fu-07/robot2/docs/overview.md

# 陆地仿生机器人挑战赛 —— 工程总纲（8 自由度四足机器人）

> 本文从原对话（`机器人挑战赛通知摘要`，800 条消息 / 151 万字符）中提炼，**只保留最终采用的方案、可直接复用的参数和真实踩过的坑**，已剔除所有被否决的中间方案。
> 用途：作为新对话的工程上下文 / 写设计说明书 / 答辩复盘。
> 最后更新：2026-10-31

---

## 0. 一句话概括

用 **STM32F103C8T6 + 8 个 SG90 舵机**做一只 8 自由度四足（机器狗）机器人，**纯开环 8 相位步态**走完 900 mm 直道，靠 **HC-05 蓝牙单步微调**做终点精准停靠，电源用 **2S 锂电 + XL4015 降压 + 2×1000 µF**，控制板为自制 **50×80 mm 双层 PCB**（Gerber 已出），机身是 **3D 打印件（75×66×10 mm）**。

**当前状态**：站立稳定；直行能走直线（最好记录 57 cm）；已加入原地左/右转；`TARGET_STEPS` 仍未标定；OLED 用 **PB12/PB13** 已点亮并能显示表情；代码工程见 `D:\下载\robot2-main`（Keil MDK，已含全部 HAL 驱动）。

---

## 1. 赛题与得分策略

### 1.1 硬性规则（来自《机器人挑战赛通知.docx》）

| 项目 | 要求 |
| --- | --- |
| 赛事 | 陆地仿生机器人挑战赛 / 2026 集成电路创新实验室招新校赛 |
| 队伍 | 2 人，机械 + 电控各 1 人 |
| 尺寸 | 静置长宽高 **均 ≤ 150 mm** |
| 驱动 | 至少 1 个电机；主推进必须靠**仿生运动机构**（轮/履带只能辅助） |
| 供电 | 仅限锂电池，**≤ 12 V** |
| 主控 | STM32 / ESP32 / Arduino |
| 关键约束 | **禁止电机开环输出**（这条决定了必须做位置闭环或"舵机内置闭环"） |
| 代码 | 必须有清晰注释，现场演示 + 答辩 |
| 赛道 | 宽 **200 mm**、长 **900 mm** |
| 基础任务 | 直行通过 900 mm，不得冲出赛道 |
| 附加任务 | 精准停靠到起跑点正对面，且机身整体越过终点线 |
| 计时 | 单次 **90 s**，赛前准备 90 s，每队 **2 次**机会取最高分 |
| 计分 | 按 900 mm 方向的有效行走距离计任务分；总分 = 现场评定 + 文档 + 创新 + 任务（100 分） |

### 1.2 本队的得分打法（已确定，不再改）

1. **基础分优先**：宁可慢，必须走完 900 mm 且不出界（出界立即停止，按出界点计分）。
2. **附加分靠"人机协同"**：不做视觉/循迹，用手机蓝牙发单步指令，肉眼对准终点线一点点挪——这是低成本方案里最稳的精准停靠。
3. **创新分靠硬件**：自制 PCB + 模块化舵机接口 + 双模控制（蓝牙 + 物理按键应急）。
4. **答辩分靠设计叙事**：8 相位错峰、非阻塞调度、电源抗扰——三个点足够讲。

### 1.3 时间预算（90 s）

| 环节 | 预算 |
| --- | --- |
| 上电自检 + 站立 | 2 s |
| 直行 900 mm | 18~30 s（0.4 s/步 × 45~75 步） |
| 蓝牙微调停靠 | 30~40 s（每按一次走 1 步） |
| 余量 | ≥ 20 s |

---

## 2. 系统总览

### 2.1 系统框图

```
        ┌──────────────┐   USART1 9600   ┌──────────┐
        │  手机 APP     │◄───────────────►│  HC-05   │
        └──────────────┘                 └────┬─────┘
                                              │ PA9/PA10
   ┌─────────────┐   8×PWM(50Hz)   ┌──────────▼──────────┐
   │ 8× SG90 舵机 │◄───────────────│  STM32F103C8T6      │
   │ 4 腿×(髋+膝) │   TIM2/TIM3    │  72MHz / HAL 库      │
   └──────┬──────┘                 └───┬──────────┬──────┘
          │ 5V 大电流                  │ I2C(软)   │ GPIO
   ┌──────▼──────┐            ┌────────▼───┐  ┌───▼─────────────┐
   │ 2×1000µF    │            │ OLED 0.96" │  │ 蜂鸣器/按键/红外   │
   │ VCC_SERVO   │            │ PB12/PB13  │  │ PB11/PB5/PB9/PB6  │
   └──────▲──────┘            └────────────┘  └─────────────────┘
          │ 5V / 5A
   ┌──────┴──────┐   7.4V   ┌──────────────┐
   │ XL4015 模块  │◄─────────│ 2S 1500mAh   │
   └─────────────┘  XT60    │ 锂电池 7.4V   │
                            └──────────────┘
```

### 2.2 硬件清单

| 类别 | 型号 / 规格 | 数量 | 说明 |
| --- | --- | --- | --- |
| 主控 | STM32F103C8T6 最小系统板（蓝板） | 1 | 72 MHz，插在自制底板上 |
| 执行器 | SG90 舵机（180°，非 360°） | 8 | 4 腿 ×（髋 1 + 膝 1） |
| 通信 | HC-05 蓝牙模块 | 1 | 主从一体，9600 8N1 |
| 显示 | 0.96" OLED，SSD1306，I2C 地址 0x78 | 1 | 软件 I2C，**PB12/PB13** |
| 电源 | 2S 锂电 7.4 V 1500 mAh，XT60 接口 | 1 | 比赛够用，调试需备 2 块 |
| 降压 | XL4015 降压模块（**外挂，不上板**） | 1 | 7.4V→5V，5A |
| 电容 | 1000 µF / 16 V 电解 | 2 | 吸收舵机启动浪涌 |
| 提示 | 有源蜂鸣器（模块，带三极管驱动） | 1 | PB11 |
| 交互 | 轻触按键 | 2 | PB5 / PB9 |
| 指示 | LED | 1 | 用核心板自带 PC13（未另加） |
| 传感 | 红外（TCRT5000） | 1 | PB6，可作终点线检测/创新点 |
| 结构 | 3D 打印身体 75×66×10 mm + 腿 31×54×11 mm ×4 + 脚 17×65×8 mm ×4 | 1 套 | 见 §12 |
| 底板 | 自制 PCB **50×80 mm**，2 层，Gerber 已出 | 1 | 见第 3 节、§11 |
| 其他 | XT60 公头、16AWG 硅胶线、JST-XH 端子、铜柱、防滑橡胶垫 | 若干 | 严禁飞线/杜邦线（指导老师要求） |

### 2.3 引脚分配表（最终版）

| 功能 | 引脚 | 外设配置 | 备注 |
| --- | --- | --- | --- |
| 舵机 1 左前髋 | PA0 | TIM2_CH1 PWM | CCR 500~2500 |
| 舵机 2 左前膝 | PA1 | TIM2_CH2 PWM | |
| 舵机 3 右前髋 | PA2 | TIM2_CH3 PWM | |
| 舵机 4 右前膝 | PA3 | TIM2_CH4 PWM | |
| 舵机 5 左后髋 | PA6 | TIM3_CH1 PWM | |
| 舵机 6 左后膝 | PA7 | TIM3_CH2 PWM | |
| 舵机 7 右后髋 | PB0 | TIM3_CH3 PWM | |
| 舵机 8 右后膝 | PB1 | TIM3_CH4 PWM | |
| 蓝牙 TX/RX | PA9 / PA10 | USART1，9600 | 开 RXNE 中断 |
| OLED SCL | **PB12** | GPIO 开漏 + 上拉 | 与原理图/PCB 一致 |
| OLED SDA | **PB13** | GPIO 开漏 + 上拉 | 与原理图/PCB 一致 |
| 蜂鸣器 | PB11 | 推挽输出 | 高电平响 |
| 按键 1 / 2 | PB5 / PB9 | 输入上拉，下降沿中断（EXTI9_5） | 中断里只置标志 |
| 板载 LED | PC13 | 推挽输出 | 蓝板自带，低电平亮 |
| 红外 | PB6 | 输入上拉 | 可作终点线检测 |

> ⚠️ **OLED 引脚有过一段弯路**：调试中 PB13 实测仅 0.48 V、屏幕不亮，一度怀疑引脚烧毁并飞线到 PB14/PB15；最后查明是**驱动库函数签名不匹配 + 初始化顺序错 + 没加延时**，换库并修好后回到板子原设计的 **PB12/PB13**。**结论：不亮先查软件，别急着换引脚。**

---

## 3. 电源与 PCB

### 3.1 电源架构（**这是本项目最大的坑**）

```
电池 XT60 → 船型/拨动开关 → 2×1000µF 并联 →┬→ XL4015 → 5V → VCC_SERVO（8 舵机，粗线 60mil）
                                            └→ 5V → VCC（MCU/蓝牙/OLED/蜂鸣器，20mil）
```

**原则：舵机的大电流路径要尽可能独立；MCU 只从电源汇合点分一条细支路取电，别和 8 个舵机共用同一条粗干路。**

- 原因：8 个 SG90 同时启动峰值 **5 A 以上**，共用一条细线会把 5 V 拉到 MCU 欠压复位（Brown-out）。
- 本项目的实际做法：**没有割焊盘，而是把引到 MCU 5V 的那段电源线线宽改小**——主控支路只分小电流，舵机侧仍走 60 mil 粗干路，形成"粗干路 + 细支路"的结构。
- ⚠️ 代价：细线本身有压降，所以必须配 2×1000 µF 蓄水电容 + 软件 8 相位错峰，否则启动/急停瞬间仍可能复位。
- 如果还能改板：把 `VCC`/`VCC_SERVO` 做成两个独立网络，在电容正极单点汇合，各自再加 100 nF 去耦。

### 3.2 线宽标准（50×80 mm，1 oz 铜）

| 档次 | 线宽 | 用途 |
| --- | --- | --- |
| 大电流 | **≥ 60 mil** | 电池输入、开关、电容正极、舵机 VCC 主干 |
| 主控 | 20 mil | 5V 主控干路、GND 主干 |
| 信号 | 10~15 mil | PWM、I2C、UART、按键 |

### 3.3 PCB 设计要点（已验证）

- 布局：电源居中/靠边、**舵机接口就近贴着 PWM 输出引脚放（PA0~PA3 / PA6、PA7、PB0、PB1）**、核心板居中竖放——舵机线不用横穿整板，线束好理，也呼应"禁止飞线/杜邦线"的要求。
- 地：**底层整片 GND 铺铜**，顶层可不铺。
- 固定：板上打的那几个孔**是为了用螺丝把板子固定在 3D 打印机身上**（不是电气缝合孔），做**非金属化（NPTH）**，防止螺丝短接底层地。
- 蓝牙：模块天线**正下方禁布铜**（设 Keep-Out）；若用杜邦线外接则无需处理。
- 舵机接口：4 个 2×3 排针（H1~H4），每口引出 `VCC_SERVO / GND / PWM`；建议改 **JST-XH** 防脱落。
- 禁止：TP4056 充电电路、XM 供电切换电路、把 3.3V 接到 5V（会烧核心板）。

---

## 4. 软件架构

### 4.1 CubeMX 配置清单（照抄即可）

**时钟**：HSE 8 MHz 晶振 → PLL ×9 → **SYSCLK 72 MHz**；AHB 72 M，APB1 36 M，APB2 72 M。

**TIM2 / TIM3（各 4 通道 PWM）**

| 参数 | 值 | 说明 |
| --- | --- | --- |
| Prescaler | **71** | 72 MHz / 72 = 1 MHz，即 1 µs 计数 |
| Counter Period (ARR) | **19999** | 20 ms 周期 = 50 Hz |
| Pulse | 1500 | 初始 90° 中位 |
| Mode | PWM Mode 1 / High | |

**USART1**：9600、8N1、无流控、PA9/PA10，**开启全局中断**（优先级 1）。

**GPIO**：见 2.3 表。OLED 两脚必须 **Output Open-Drain + Pull-up**（软件 I2C 总线要求，推挽会烧屏）。

**中断**：只开 USART1（蓝牙）+ SysTick。按键/红外若要中断，走 EXTI9_5。

### 4.2 代码结构（`robot2-main` 实际布局）

```
robot2-main/
├── robot.ioc                    CubeMX 工程文件
├── Core/
│   ├── Inc/   main.h  tim.h  usart.h  gpio.h  stm32f1xx_it.h  hal_conf
│   └── Src/   main.c  tim.c  usart.c  gpio.c  stm32f1xx_it.c  msp
├── HARDWARE/                    ← 手写驱动（Keil 里要加进 include path）
│   ├── OLED.c / OLED.h / OLED_Data.c / oledfont.h / bmp.h
│   ├── bluetooth.c / bluetooth.h
│   ├── key.c / key.h
│   └── motion.h（状态枚举）、motion.c（空文件）
└── MDK-ARM/                     Keil 工程 robot.uvprojx
```

- 步态、姿态、调度全部在 `Core/Src/main.c`（`SetServo` / `Robot_Stand` / `Robot_Walk_Forward_Step` / `Robot_Turn_*_Step` / `Robot_Gait_Run` / `BT_Process` / `OLED_ShowFace`）。
- `HARDWARE\` 需在 Keil 的 `Options → C/C++ → Include Paths` 中加入，否则 `OLED.h` 等找不到。
- 同目录 `robot_main.c` 与本仓 `Core/Src/main.c` **完全一致**（已比对哈希），可直接对照。

### 4.3 三层架构（答辩就用这个说法）

```
第一层  宏观任务状态机   currentMotion: MOTION_STOP / FORWARD / TURN_LEFT / TURN_RIGHT
第二层  微观步态相位机   stepPhase: 0~7，每次只执行一个相位（错峰）
第三层  非阻塞调度       HAL_GetTick() 时间片，不用 HAL_Delay 卡死主循环
```

> 注意：`TURN_LEFT / TURN_RIGHT` 一旦进入会**一直原地转**，只有发 `'0'` 才停——比赛用不上就别按，或改成"转 N 步自动回 STOP"。

### 4.4 8 相位步态（对角步态 Trot 的简化版）

| 相位 | 动作 | 目的 |
| --- | --- | --- |
| 0 | 回到准备姿态 | 每步重新对齐基准 |
| 1 | 抬左前膝(2)、右后膝(8) | 对角支撑 |
| 2 | 左前髋(1)、右后髋(7) 迈步 | 产生推力 |
| 3 | 左前膝、右后膝落地 | |
| 4 | 抬右前膝(4)、左后膝(6) | 换对角 |
| 5 | 右前髋(3)、左后髋(5) 迈步 | |
| 6 | 右前膝、左后膝落地 | |
| 7 | 四髋回正一半 | 重心过渡，防侧翻 |

**为什么拆 8 个相位而不是一次全动**：① 峰值电流从 5 A 压到 ~1.5 A；② 机械不打架；③ 重心转移平滑不侧翻。这一点是答辩的必答项。

### 4.5 蓝牙协议（极简单字符）

| 指令 | 动作 | 用途 |
| --- | --- | --- |
| `'1'` | 进入 `MOTION_FORWARD`，`motionSteps=0` | 开跑 |
| `'0'` | 立即 `MOTION_STOP` + `Robot_Stand()` | 急停（保命） |
| `'2'` | `micro_step_request=1`，走完整 1 步 | 终点微调 |
| `'3'` | 进入 `MOTION_TURN_LEFT` | 原地左转（持续） |
| `'4'` | 进入 `MOTION_TURN_RIGHT` | 原地右转（持续） |

接收方式：USART1 RXNE 中断里只做"收字节 + 置标志"，**绝不在中断里跑步态**，主循环 `BT_Process()` 解析。这样急停延迟 < 10 ms。

---

## 5. 关键参数与标定

### 5.1 舵机角度映射

```c
pulse = angle / 180.0f * 2000.0f + 500.0f + 0.5f;   // 0°→500, 180°→2500
```
1 MHz 计数下，500~2500 对应 SG90 的 0.5~2.5 ms。`+0.5f` 是四舍五入，减 ±0.5° 的量化误差。

### 5.2 黄金站姿（实测能站稳，别乱改）

| 舵机 | 1 左前髋 | 2 左前膝 | 3 右前髋 | 4 右前膝 | 5 左后髋 | 6 左后膝 | 7 右后髋 | 8 右后膝 |
| --- | --- | --- | --- | --- | --- | --- | --- | --- |
| 角度 | 90 | **76** | 90 | **95** | 90 | **80** | 90 | **100** |

四髋全 90° 保证指向前后；四个膝角各不相同，是**打印件公差 + 舵机齿位误差**的补偿，不是笔误。
> 换新舵机/重新装配后必须重新调这 4 个值：先让机器人四脚均匀着地，再微调膝盖直到不晃、不翘脚。

### 5.3 步态参数（`main.c` 顶部宏）

| 宏 | 现值 | 含义 | 怎么调 |
| --- | --- | --- | --- |
| `SIDE_ANGLE` | **20** | 大腿前后摆幅（°） | 越大步幅越大；>30 容易侧翻 |
| `TURN_ANGLE` | **25** | 原地转向时髋关节偏移（°） | 越大转得越快，>30 易扭 |
| `STEP_DELAY` | **100 ms** | 单个相位时长 | 8 相位 = **800 ms/步**；改小提速但易打滑 |
| `TARGET_STEPS` | **60** | 走完 900 mm 的步数 | **必须实测标定，见下** |

> 按当前参数：一步 0.8 s，60 步 = **48 s**，加急停/微调仍在 90 s 内，但偏慢。若标定后步数 < 45，可把 `STEP_DELAY` 降到 70~80 ms 换速度。

### 5.4 距离标定流程（做一次，10 分钟）

1. 地面贴 1 m 胶带尺，起点对齐机器人**机身中心**。
2. 临时把 `TARGET_STEPS` 改成 20，蓝牙发 `'1'` 跑完，量实际位移 `D`（mm）。
3. 单步位移 `d = D / 20`。
4. `TARGET_STEPS = round(900 / d)`，再留 1~2 步余量（宁少勿多，越界即 0 分）。
5. 复测一次 900 mm，偏差 > 30 mm 就重标。

> 历史数据只能参考、不能直接抄：曾测到 10 步走 200 mm（d=20 mm，900 mm≈45 步），也出现过 95 步只走 200 mm（d≈2 mm，说明当时步态在"原地蹭"）。**换一次代码/换一次地面，d 就会变。**

### 5.5 调参顺序（别跳步）

```
站立稳定 → 单步能迈出（不打滑） → 走 3 步不偏 → 走 10 步标定 d → 算 TARGET_STEPS
        → 走 900 mm 看偏航 → 微调左右差速 → 终点蓝牙微调
```

---

## 6. 踩坑清单（最值钱的部分）

| # | 现象 | 根因 | 结论 |
| --- | --- | --- | --- |
| 1 | 舵机只响不转 | 信号共地没接 / 供电不足 | 舵机电源与 MCU **必须共地**；不要用 MCU 的 5V 带舵机 |
| 2 | 上电 1 号舵机狂转 | PWM 未初始化就输出 / 角度越界 | 先 `HAL_TIM_PWM_Start` 再给角度；确认是 180° 舵机 |
| 3 | 8 舵机一起动就复位 | 浪涌电流拉低 5V | 主控支路走细线 + 2×1000 µF 蓄水 + 8 相位错峰 |
| 4 | OLED 死活不亮 | ①`OLED_Init()` 写在 `HAL_Init()` 之前；②一度怀疑 PB12/PB13 烧了（**误判**）；③驱动库函数签名不对（`OLED_ShowString` 少参数、`OLED_Update/Refresh` 名字不符）；④`SCL_Set` 宏里错写成 `SDA_Pin` | 排查顺序：先点灯验主控 → 再 I2C 扫址（0x78）→ 再换引脚 → 最后换库。**扫址能收到 ACK 就说明硬件没问题** |
| 5 | 机器人原地抽搐 | 四腿同时前/后摆，推力互相抵消 | 必须做成对角两组交替，且一组落地时另一组抬起 |
| 6 | 走两步就偏 180° | 左右步幅差速过大 / 单侧打滑 | 先做**绝对对称**的基准步态，再按 1°~2° 微调差速 |
| 7 | 贴双面胶反而更偏 | 单侧摩擦突变，形成"锚点" | 四脚摩擦必须一致；防滑用网格橡胶垫，别用双面胶 |
| 8 | 抬腿就侧翻 | 机身太轻，舵机反作用力顶起底盘 | 加配重（电池位置）+ 减小 `SIDE_ANGLE` + 降低 `STEP_DELAY` |
| 9 | 95 步只走 20 cm | 该版本步态"贴地蹭行"，无抬腿 | 抬腿相位不能省；否则单步位移极小 |
| 10 | 换引脚后仍黑屏 | 只改了宏定义，`gpio.c`/CubeMX 没重新生成 | 改引脚必须 **CubeMX 重新生成 + 检查 main.h 宏** |
| 11 | 编译报 `Undefined symbol SystemClock_Config` | 覆盖 main.c 时把 CubeMX 生成的函数删了 | 保留 `SystemClock_Config` / `Error_Handler` |

---

## 7. 遗留问题 / TODO（按优先级）

| 优先级 | 事项 | 说明 |
| --- | --- | --- |
| P0 | **标定 `TARGET_STEPS`** | 现在写的是 **60**，纯估值。60 步 × 0.8 s = 48 s，若实际单步位移不是 15 mm，就会走不够或冲线 |
| P0 | 给 `bt_recv_flag/bt_recv_char` 加 `volatile` | 现在这两个变量在中断里写、主循环里读，**没加 volatile**。Keil -O0 能跑，开 -O1/-O2 可能被优化掉导致蓝牙"偶尔失灵" |
| P0 | 验证蓝牙 `'2'` 单步微调 | `for(8){Step(); HAL_Delay(100)}` 会阻塞 800 ms，且要求 `currentMotion==STOP`；比赛连按会丢指令 |
| P1 | 900 mm 全程偏航复测 | 开环必偏，记录"跑完 900 mm 的横向偏移"作为指标 |
| P1 | 转向状态加退出条件 | `'3'/'4'` 进入后只会一直转，必须发 `'0'` 才停；建议改成转 N 步自动回 `MOTION_STOP` |
| P1 | 检查 `Robot_Prepare_Sideways()` 的 150/30 | 起步姿态是 **150/30 强不对称**，而相位 2/7 又按 120/60 计算，这是历史"左偏"的最大嫌疑点，建议统一成 120/60 再看偏航 |
| P2 | 红外终点检测 | PB6 已配置输入上拉，检测到白线自动停 + 蜂鸣，替代纯肉眼 |
| P2 | OLED 运行态显示 | 现在只在开机显示表情，跑起来看不到步数；建议空闲时刷 `Step:x/60`（200 ms 一次即可） |
| P3 | PCB v2 | 舵机口改 JST-XH、补限流电阻、VCC/VCC_SERVO 复核 |
| P3 | IMU（MPU6050）姿态闭环 | 加分项，但赛前不要动 |
| P3 | 文档三件套 | 装配图、零件图、BOM、电控原理框图、设计说明书 |

---

## 8. 答辩话术（精简版）

**Q：控制架构？**
主控 STM32F103 出 8 路 50 Hz PWM 跑 8 相位状态机；执行层是 8 个 SG90，内部电位器自带关节闭环；通信层 HC-05 收手机指令，OLED 实时回显状态；整体非阻塞调度，急停指令随时可打断。

**Q：没有 IMU，怎么保证走直？**
承认是"开环步态 + 人工微调"：底层靠舵机闭环，顶层靠赛前标定的对称步态 + 蓝牙单步补偿。并说明取舍："20 天周期里，稳定完赛优先于姿态闭环；若加 MPU6050，会对 Roll/Pitch 做串级 PID。"

**Q：为什么拆 8 个相位？**
一次全动峰值 5 A 会拉垮 5 V 导致 MCU 复位；拆分后每次最多 2 个舵机动作，峰值降到 1.5 A，同时重心转移平滑、机械不干涉。

**Q：电源怎么抗干扰？**
2S 锂电 → XL4015 → 5 V；两颗 1000 µF 作蓄水池；舵机 60 mil 粗干路 + 主控细支路；底层整片铺地。

**Q：这套代码的工程亮点？**
① `HAL_GetTick()` 非阻塞调度，不用死延时；② 8 相位 + `static` 相位记忆实现错峰；③ `micro_step_request` 标志位实现毫米级停靠；④ `SetServo(id,angle)` 把业务层与 TIM 通道解耦。

---

## 9. 已否决的方案（别回头）

| 方案 | 否决原因 |
| --- | --- |
| STM32F407 + TB6612 + JGA25370 编码器电机 | 光轴无联轴器，机械做不出来；且 F407 板太大塞不进 150 mm |
| 仿尺蠖蠕动机器人（单电机曲柄滑块） | 需要 3D 打印传动件，无设备 |
| 4 舵机四足 | 只能爬，不能站，视觉分低；已升级 8 舵机 |
| 轮式/履带主推进 | 违反"仿生推进"规则 |
| TP4056 充电 + DW01 保护板带舵机 | 1 A 级芯片带 5 A 负载，必炸 |
| 供电自动切换电路（AO3401+SS34） | 增加故障点，收益为零 |
| 超声波 / 多路红外循迹 | 赛道是直道，用不上；单路红外只做终点检测 |
| 3.3 V 供电（板上无 3.3 V 需求） | 核心板自带上电，接 5 V 即可 |
| XL4015 上板 | 时间不够、布局放不下，外挂模块更稳 |
| OLED 改 DMA/硬件 SPI | 赛前优化，风险大于收益 |

---

## 10. 新对话开场提示词（可直接复制）

```
我在做一个 8 自由度四足机器人（STM32F103C8T6 + 8×SG90 + HC-05 + 自制 50×80 PCB），
任务是走完 900mm 直道并精准停靠。已有：CubeMX 工程（TIM2/TIM3 各 4 路 50Hz PWM，
PSC=71 ARR=19999）、8 相位错峰步态、黄金站姿、蓝牙 '1'/'0'/'2'/'3'/'4' 协议、非阻塞调度。
当前状态：站立稳定，直行基本能走直线，但 TARGET_STEPS 未标定、长距离有偏航。
接下来我要做：① 标定步数与距离；② 修正 900mm 全程偏航；③ 写设计说明书。
请在此基础上继续，不要建议改架构。
```

---

## 11. 工程文件与实物清单

### 11.1 PCB（`四足蜘蛛.zip` → Gerber）

- 设计软件：嘉立创 EDA Pro v3.2.91，导出时间 2026-10-31
- **板框尺寸：50.00 × 79.88 mm**（GKO 层实测），2 层板
- 含 14 个文件：GTL/GBL（铜层）、GTO/GBO（丝印）、GTS/GBS（阻焊）、GKO（板框）、GDL/GDD（孔图）、3 个 DRL（PTH/NPTH/过孔）、`FlyingProbeTesting.json`（飞针测试文件）
- 下单：直接整包上传嘉立创，2 层 / 1.6 mm / 1 oz，有 NPTH 孔
- ⚠️ 板长 **80 mm 比机身（75/66）都长**：若长边顺 75 方向，前后各探出 2.5 mm；若顺 66 方向，则探出 14 mm。装机前先比一下孔位，必要时把板架高或改薄铜柱

### 11.2 结构件（4 个 STL）

| 文件 | 实测包围盒 (mm) | 数量 | 说明 |
| --- | --- | --- | --- |
| `四足机器人身体.stl` | **75.0 × 66.0 × 10.0** | 1 | 机身主板，中心在原点 |
| `四足机器人-腿1X2.stl` | 31.0 × 54.0 × 11.1 | 2 | 腿（左右镜像用同一件？需确认） |
| `四足机器人-腿2X2.stl` | 31.0 × 54.0 × 11.1 | 2 | 与上者尺寸相同、应为镜像件 |
| `四足机器人-脚X4.stl` | 17.0 × 65.0 × 8.0 | 4 | 脚掌/小腿 |

> 两个腿件包围盒完全一致（31×54×11.1），差异在内部结构，**打印时按文件名分批，别混**；数量按文件名里的 `X2 / X4` 打印（腿各 2 件、脚 4 件）。

### 11.3 150 mm 尺寸校核（赛前必做）

规则是**静置状态**长宽高均 ≤ 150 mm。机身本体 75×66 没问题，风险在四条腿外伸：

| 方向 | 机身尺寸 | 允许外伸 | 判定方法 |
| --- | --- | --- | --- |
| 左右（宽） | 66 mm | **每侧 ≤ 42 mm** | 腿完全展开后量总宽 |
| 前后（长） | 75 mm | **每端 ≤ 37.5 mm** | 量总长 |
| 高度 | 10 mm（板） | 站立总高 ≤ 150 mm | 几乎不可能超 |

**结论：站立展开时若单侧外伸超过 37.5 mm 就超尺寸。** 处理办法：① 比赛检录时把腿收拢成"趴伏姿态"再量；② 或缩短脚掌外伸量。**现在没有实测数据，这一项必须用卡尺量一次并拍照留证。**

---

## 附录 A：仓库里已有的接口（不用自己写）

`robot2-main` 已经包含全部依赖，**不要再照抄我上一版补的胶水代码**，以仓库为准：

| 文件 | 关键内容 |
| --- | --- |
| `HARDWARE/motion.h` | `MotionState`：`MOTION_STOP / FORWARD / TURN_LEFT / TURN_RIGHT` |
| `HARDWARE/bluetooth.c` | `BT_Init()` 启动单字节中断接收；`HAL_UART_RxCpltCallback` 里置 `bt_recv_flag`；另有 `BT_SendString/Byte` |
| `HARDWARE/OLED.c` + `OLED_Data.c` | 软件 I2C 驱动 + 字库；`OLED_Refresh()` 整屏刷新 |
| `HARDWARE/key.c` | 按键 EXTI 回调 |
| `Core/Src/tim.c` | PSC=71、ARR=19999、Pulse=1500、PWM1 |
| `Core/Src/gpio.c` | OLED 两脚 `GPIO_MODE_OUTPUT_OD + PULLUP`；按键 `IT_FALLING`；红外 `INPUT + PULLUP` |

**已知代码问题（建议改，改动极小）**：

```c
/* bluetooth.c —— 中断与主循环共享，必须 volatile，否则 -O2 下可能失效 */
volatile uint8_t bt_recv_char;
volatile uint8_t bt_recv_flag = 0;

/* main.c —— 转向没有出口，建议加步数限制 */
if (currentMotion == MOTION_TURN_LEFT && ++turn_steps > 20) {
    currentMotion = MOTION_STOP; Robot_Stand();
}
```

---

*附：本文件与 `robot2-main`（`Core/Src/main.c`）、`robot_main.c`（与其哈希一致）、PCB Gerber、4 个 STL 均已核对；原始对话见 `会话全文.md`。*
