fu-07/robot2/HARDWARE/BOM.csv

序号 | 类别 | 名称 | 型号/规格 | 数量 | 封装/尺寸 | 备注 | 单价(元) | 小计(元)
1 | 主控 | STM32 核心板 | STM32F103C8T6 72MHz 64KB Flash | 1 | BluePill 53×22mm | 插装于底板 | 待补
2 | 执行器 | 舵机 | SG90 180° 9g | 8 | 23×12.2×29mm | 4 腿×(髋+膝) | 待补
3 | 通信 | 蓝牙模块 | HC-05 主从一体 | 1 | 约 27×13mm | 9600 8N1 | 待补
4 | 显示 | OLED 模块 | 0.96" SSD1306 I2C 地址 0x78 | 1 | 27×27mm | 软件 I2C PB12/PB13 | 待补
5 | 电源 | 锂电池 | 2S 7.4V 1500mAh XT60 | 1 | 约 70×35×20mm | 比赛用；调试建议 2 块 | 待补
6 | 电源 | 降压模块 | XL4015 5A 可调 | 1 | 约 62×25mm | 调到 5.0V 后再接板 | 待补
7 | 电源 | 电解电容 | 1000uF / 16V | 2 | Φ10×20mm | 舵机浪涌蓄水 | 待补
8 | 提示 | 蜂鸣器模块 | 有源 3.3~5V | 1 | 约 12×10mm | 接 PB11 | 待补
9 | 交互 | 轻触按键 | 6×6×5 直插 | 2 | - | PB5 / PB9 | 待补
10 | 传感 | 红外循迹模块 | TCRT5000 | 1 | 约 32×12mm | PB6，可做终点检测 | 待补
11 | 结构 | PCB | 50×80mm 2 层 1.6mm 1oz | 1 | - | 嘉立创打样（见 hardware/gerber） | 待补
12 | 结构 | 3D 打印件 | 机身 1 + 腿 ×4 + 脚 ×4 | 1 套 | - | PLA/PETG 均可 | 待补
13 | 线材 | XT60 公头 + 16AWG 硅胶线 | 1 套 | - | 自己焊比成品线可靠 | 待补
14 | 连接器 | JST-XH 3P 带线 | 8 套 | - | 替代排针防脱落（推荐） | 待补
15 | 紧固 | M3 铜柱 + 螺丝螺母 | 若干 | M3×10~20 | 固定 PCB 与舵机 | 待补
