fu-07/robot2/mechanical/foot_x4.stl

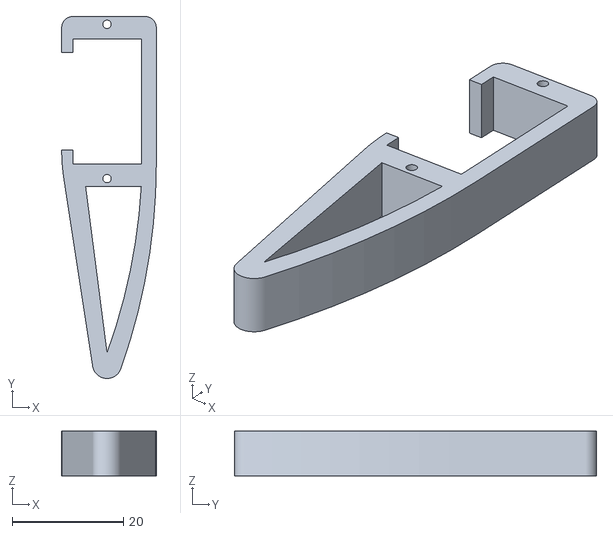
[picture p1: CAD file, 2026-11-03]
mechanical/foot_x4.stl
17.0 x 65.0 x 8.00
