fu-07/robot2/mechanical/leg_a_x2.stl

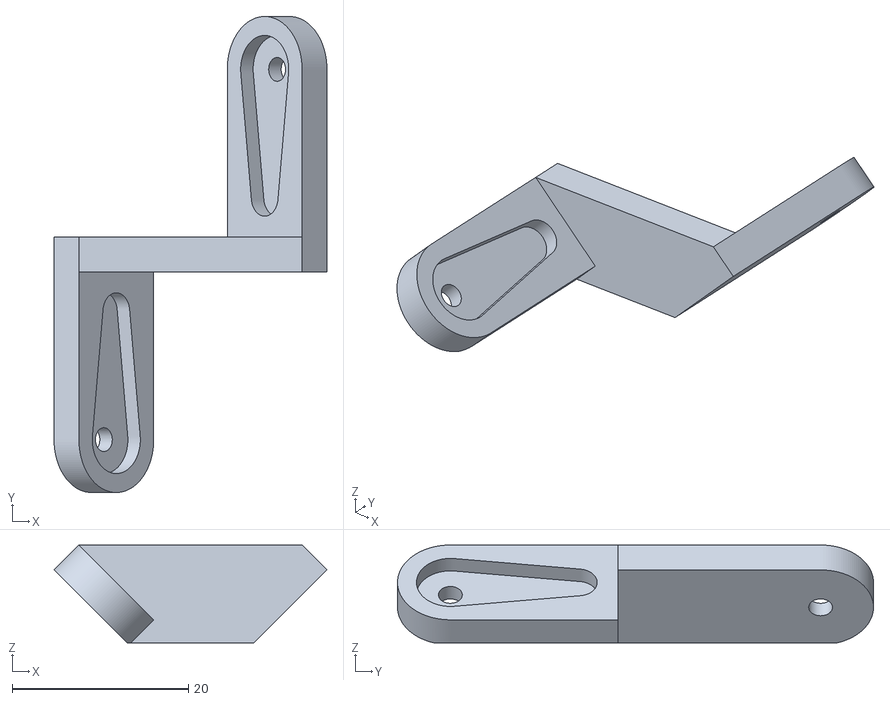
[picture p2: CAD file, 2026-11-03]
mechanical/leg_a_x2.stl
31.0 x 54.0 x 11.1
