fu-07/robot2/(list of files, cad)

Other CAD files:
mechanical/leg_b_x2.stl
