fu-07/robot2/robot.ioc

Mcu.UserName=STM32F103C8Tx
PA0-WKUP.Signal=S_TIM2_CH1_ETR
PA1.Signal=S_TIM2_CH2
PA10.Signal=USART1_RX
PA13.Signal=SYS_JTMS-SWDIO
PA14.Signal=SYS_JTCK-SWCLK
PA2.Signal=S_TIM2_CH3
PA3.Signal=S_TIM2_CH4
PA6.Signal=S_TIM3_CH1
PA7.Signal=S_TIM3_CH2
PA9.Signal=USART1_TX
PB0.Signal=S_TIM3_CH3
PB1.Signal=S_TIM3_CH4
PB11.GPIO_Label=BEEP
PB11.Signal=GPIO_Output
PB12.GPIO_Label=OLED_SCL
PB12.Signal=GPIO_Output
PB13.GPIO_Label=OLED_SDA
PB13.Signal=GPIO_Output
PB5.GPIO_Label=KEY1
PB5.Signal=GPXTI5
PB6.GPIO_Label=TRIN
PB6.Signal=GPIO_Input
PB9.GPIO_Label=KEY2
PB9.Signal=GPXTI9
PC13-TAMPER-RTC.Signal=GPIO_Output
PD0-OSC_IN.Signal=RCC_OSC_IN
PD1-OSC_OUT.Signal=RCC_OSC_OUT
