fu-07/robot2/Core/Inc/main.h

#define BEEP_Pin GPIO_PIN_11
#define BEEP_GPIO_Port GPIOB
#define OLED_SCL_Pin GPIO_PIN_12
#define OLED_SCL_GPIO_Port GPIOB
#define OLED_SDA_Pin GPIO_PIN_13
#define OLED_SDA_GPIO_Port GPIOB
#define KEY1_Pin GPIO_PIN_5
#define KEY1_GPIO_Port GPIOB
#define KEY1_EXTI_IRQn EXTI9_5_IRQn
#define TRIN_Pin GPIO_PIN_6
#define TRIN_GPIO_Port GPIOB
#define KEY2_Pin GPIO_PIN_9
#define KEY2_GPIO_Port GPIOB
#define KEY2_EXTI_IRQn EXTI9_5_IRQn
