fu-07/robot2/HARDWARE/bmp.h

#ifndef __BMP_H
#define __BMP_H

#include "oled.h"	

/**
  ******************************************************************************
  * @file           : bmp.h
  * @author         : 星辰StellarSignals  
  * @date			: 2024.8.11
  ******************************************************************************
  * @attention
  * 最大x 128
  * 最大y 64
  * Copyright (c,h)  星辰StellarSignals.
  * All rights reserved.
  *
  * No notification is required if you use it yourself, but use this code to send videos, etc.
  * you must get permission from the author to transplant, thank you for your support.
  * 
  *
  ******************************************************************************
  */

/***
		
		@attention :When you want to use it you want the main function to put this(要使用时要主函数放这个)
		
		OLED_ShowPicture(0,0,128,64,bmp1,1);
		OLED_Refresh();
	  ****/

const unsigned char bmp1[] ={

0x00,0x00,0x00,0x00,0x00,0x00,0x00,0x00,0x00,0x00,0x00,0x00,0x00,0x00,0x00,0x00,0x00,0x00,0x00,0x00,0x00,0x00,0x00,0x00,0x00,0x00,0x20,0xE0,0xC0,0xC0,0xC0,0x40,0xC0,0x80,0x00,0x00,0x00,0x00,0x00,0x00,0x00,0x00,0x00,0x00,0x00,0x00,0x00,0x00,0x00,0x00,0x00,0x00,0x00,0x00,0x00,0x00,0x00,0x00,0x00,0x00,0x00,0x00,0x00,0x00,0x00,0x00,0x00,0x00,0x00,0x00,0x00,0x00,0x00,0x00,0x00,0x00,0x00,0x00,0x00,0x00,0x00,0x00,0x00,0x00,0x00,0x00,0x00,0x00,0x00,0x00,0x00,0x00,0x00,0x80,0xC0,0xC0,0xC0,0x80,0x00,0x00,0x00,0x00,0x00,0x00,0x00,0x00,0x00,0x00,0x00,0x00,0x00,0x00,0x00,0x00,0x00,0x00,0x00,0x00,0x00,0x00,0x00,0x00,0x00,0x00,0x00,0x00,0x00,0x00,0x00,0x00,0x00,0x00,0x00,0x00,0x00,0x00,0x00,0x00,0x00,0x00,0x00,0x00,0x00,0x00,0x00,0x00,0x00,0x00,0x00,0x00,0x00,0x00,0x14,0xFC,0xF7,0xFF,0xFF,0xFF,0xFF,0xFF,0xFF,0xFF,0xFF,0x80,0x00,0x00,0x00,0x00,0x00,0x00,0x00,0x00,0x00,0x00,0x00,0x00,0x00,0x00,0x00,0x00,0x00,0x00,0x00,0x00,0x00,0x00,0x00,0x00,0x00,0x00,0x00,0x00,0x00,0x00,0x00,0x00,0x00,0x00,0x00,0x00,0x00,0x00,0x00,0x00,0x00,0x00,0x00,0x00,0x00,0x00,0x00,0x00,0x00,0x00,0x00,0x00,0x00,0x78,0xC0,0xFA,0xFB,0xFF,0xFF,0xFF,0xFF,0xFF,0xFF,0xFE,0xF8,0x00,0x00,0x00,0x00,0x00,0x00,0x00,0x00,0x00,0x00,0x00,0x00,0x00,0x00,0x00,0x00,0x00,0x00,0x00,0x00,0x00,0x00,0x00,0x00,0x00,0x00,0x00,0x00,0x00,0x00,0x00,0x00,0x00,0x00,0x00,0x00,0x00,0x00,0x00,0x00,0x00,0x00,0x00,0x00,0x00,0x00,0x00,0x00,0x00,0x00,0x00,0x01,0x0F,0x07,0x1F,0x7F,0x7F,0x7F,0x7F,0x3F,0x17,0x0F,0x00,0x00,0x00,0x00,0x00,0x00,0x00,0x00,0x00,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
{
  __IO uint32_t Delay = nus * Your_JingZhen_Pinlu / 8;//(SystemCoreClock / 8U / 1000000U)
    //见stm32f1xx_hal_rcc.c -- static void RCC_Delay(uint32_t mdelay)
  do
  {
    __NOP();
  }
  while (Delay --);
}
void ikun_delay_ms(uint32_t nms)
{
   while(nms--)
   {
	   ikun_delay_us(1000);
   }
}

void ikun_C_T_Rap_Music (void)
{
	  OLED_Clear();
	  OLED_ShowPicture(L_X3,0,64,64,ikun1,1);
	  OLED_Refresh();
	  ikun_delay_ms(802);
	  OLED_ShowPicture(L_X3,0,64,64,ikun2,1);
	  OLED_Refresh(); 
 	  ikun_delay_ms(802);	
	  OLED_ShowPicture(L_X3,0,64,64,ikun3,1);
	  OLED_Refresh();
	  ikun_delay_ms(802);
	  OLED_ShowPicture(L_X3,0,64,64,ikun4,1);
	  OLED_Refresh(); 
 	  ikun_delay_ms(802);	
	  OLED_ShowPicture(L_X3,0,64,64,ikun5,1);
	  OLED_Refresh();
	  ikun_delay_ms(802);
	  OLED_ShowPicture(L_X3,0,64,64,ikun6,1);
	  OLED_Refresh(); 
 	  ikun_delay_ms(802);	
	  
	  for(int ikun_i = 0;ikun_i<5;ikun_i++)
	{
	  OLED_ShowPicture(L_X3,0,64,64,ikun7,1);
	  OLED_Refresh();
	  ikun_delay_ms(250);
	  OLED_ShowPicture(L_X3,0,64,64,ikun8,1);
	  OLED_Refresh(); 
 	  ikun_delay_ms(250);	
	}
}
#endif
