fu-07/robot2/(commit log)

2026-10-18 Initial commit: STM32 robot project
2026-10-18 只跑运动逻辑版
2026-10-20 任务一滑行版本（摩擦力自平衡）
2026-10-24 贴地飞行版本
2026-10-24 贴地飞行
2026-10-31 添加左右转，参加比赛的版本（微微向右偏，不过可以靠蓝牙遥控调整）
2026-11-03 docs: 补齐 README、Gerber、BOM、STL 与工程文档
2026-11-03 fix: PCB 资料移到 pcb/，避免与固件 HARDWARE/ 目录大小写冲突
2026-11-03 chore: 移除编译产物与个人配置的版本跟踪
2026-11-03 fix: 修复 README 中文乱码（PowerShell 按 GBK 读取导致）
2026-11-03 docs: README 增加 Release 下载入口
    Added badges for release and PCB in README.
